kolontsov/ttsky-journey/docs/layout.png

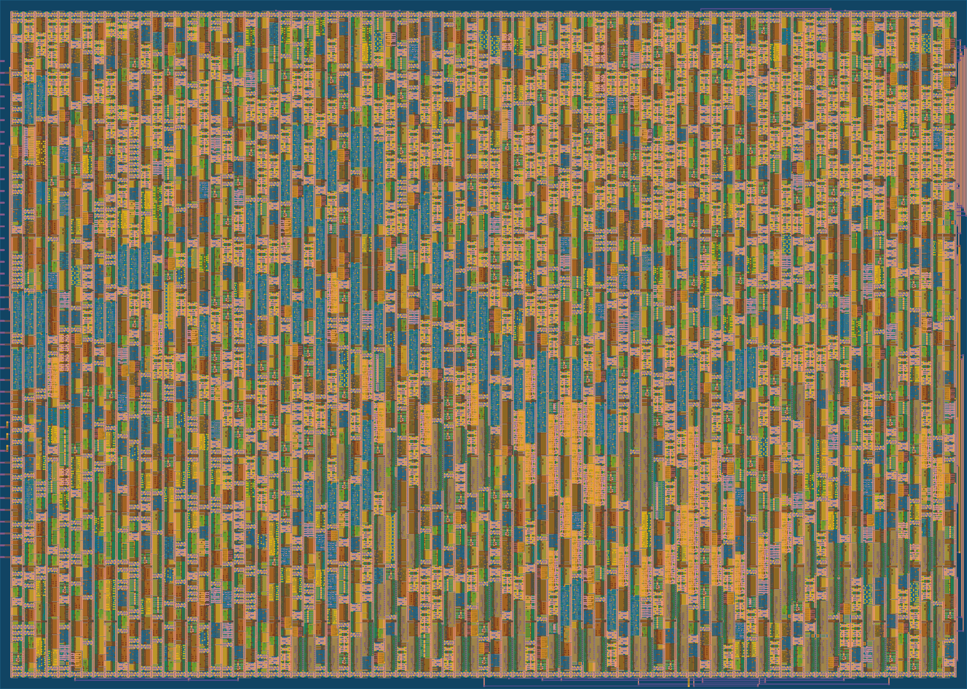
docs/layout.png
