kolontsov/ttsky-journey/scripts/data/balloon.gif

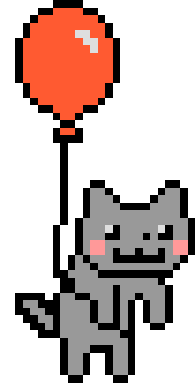
scripts/data/balloon.gif
