kolontsov/ttsky-journey/src/palette.sv

/*
 * Copyright (c) 2026 Vadim Kolontsov
 * SPDX-License-Identifier: Apache-2.0
 *
 * 256-entry palette ROM. Case data emitted by scripts/gen_palette.py.
 *
 *   colour  R/G/B = sin(i*pi/128 + {0,2,4}) lobes, RGB222
 *   gray    3 cycles of sin over 256 entries (NOT a power of 2 — avoids
 *           resonance with the tunnel's 4-fold symmetry that produced
 *           a visible cross at freq=4)
 *
 *   packing data[7:6]=gray, [5:4]=R, [3:2]=G, [1:0]=B
 */

`default_nettype none

module palette (
    input  wire [7:0] idx,
    output wire [1:0] r,
    output wire [1:0] g,
    output wire [1:0] b,
    output wire [1:0] gray
);

    logic [7:0] data;

    always_comb begin
        case (idx)
            8'd0: data = 8'b10101100;
            8'd1: data = 8'b10101100;
            8'd2: data = 8'b10101100;
            8'd3: data = 8'b10101100;
            8'd4: data = 8'b10101100;
            8'd5: data = 8'b10101100;
            8'd6: data = 8'b10101100;
            8'd7: data = 8'b10101100;
            8'd8: data = 8'b10101100;
            8'd9: data = 8'b10101100;
            8'd10: data = 8'b11101100;
            8'd11: data = 8'b11101100;
            8'd12: data = 8'b11101100;
            8'd13: data = 8'b11101100;
            8'd14: data = 8'b11101100;
            8'd15: data = 8'b11101100;
            8'd16: data = 8'b11101100;
            8'd17: data = 8'b11101100;
            8'd18: data = 8'b11101100;
            8'd19: data = 8'b11101100;
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
            8'd253: data = 8'b01011100;
            8'd254: data = 8'b01101100;
            8'd255: data = 8'b01101100;
        endcase
    end

    assign gray = data[7:6];
    assign r    = data[5:4];
    assign g    = data[3:2];
    assign b    = data[1:0];

endmodule
