kolontsov/ttsky-journey/(commit log)

2026-04-15 switch to 1x2 tiles
2026-05-06 fix test to work with gate-level netlist; cosmetic readme change
    [test.py]
2026-05-06 skip GL audio toggle check (unreset SD accum stays X in iverilog)
    [test.py]
